muryamuya/auto-spray-esp8266-atmega328p/schematics/1st iteration/mainboard/mainboard.kicad_pcb

## KiCad design schematics/1st iteration/mainboard/mainboard.kicad_pcb (2023-01-12)

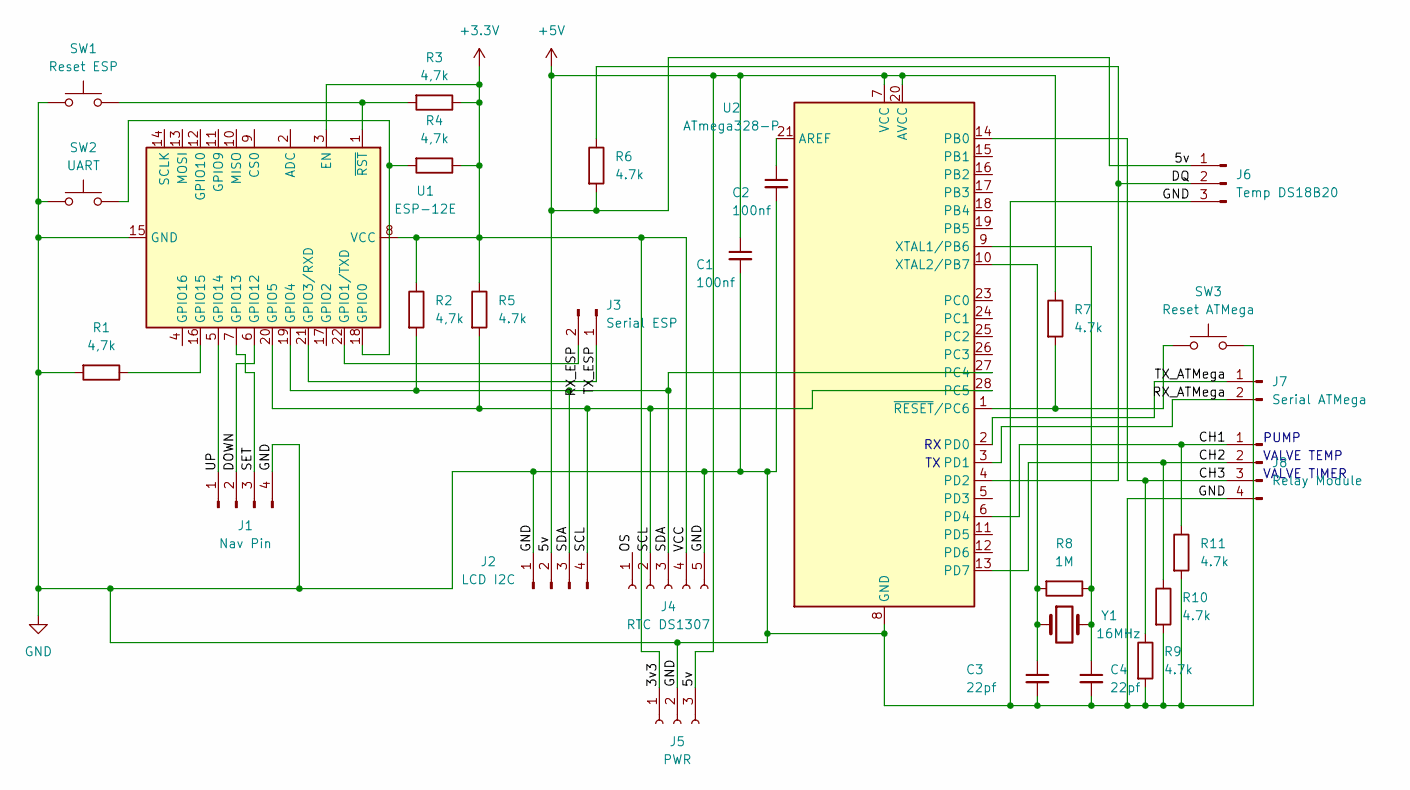
[picture p1: schematic mainboard.kicad_sch]

Parts:
C1, C2: 100nf; C_Disc_D4.7mm_W2.5mm_P5.00mm
C3, C4: 22pf; C_Disc_D4.7mm_W2.5mm_P5.00mm
J1: Nav Pin; PinHeader_1x04_P2.54mm_Vertical
J2: LCD I2C; PinHeader_1x04_P2.54mm_Vertical
J3: Serial ESP; PinHeader_1x02_P2.54mm_Vertical
J4: RTC DS1307; PinSocket_1x05_P2.54mm_Vertical
J5: PWR; TerminalBlock_bornier-3_P5.08mm
J6: Temp DS18B20; PinHeader_1x03_P2.54mm_Vertical
J7: Serial ATMega; PinHeader_1x02_P2.54mm_Vertical
J8: Relay Module; PinHeader_1x04_P2.54mm_Vertical
R1, R2, R3, R4: 4,7k; R_Axial_DIN0207_L6.3mm_D2.5mm_P7.62mm_Horizontal
R5, R6, R7, R9, R10, R11: 4.7k; R_Axial_DIN0207_L6.3mm_D2.5mm_P7.62mm_Horizontal
R8: 1M; R_Axial_DIN0207_L6.3mm_D2.5mm_P7.62mm_Horizontal
SW1: Reset ESP; SW_PUSH_6mm
SW2: UART; SW_PUSH_6mm
SW3: Reset ATMega; SW_PUSH_6mm
U1: ESP-12E
U2: ATmega328-P; DIP-28_W7.62mm
Y1: 16MHz; Crystal_HC49-U_Vertical

Connections:
+3.3V: J4.4, J5.1, R2.1, R3.1, R4.1, R5.1, U1.3 (EN), U1.8 (VCC)
+5V: C1.1, J2.2, J5.3, J6.1, R6.2, R7.1, U2.7 (VCC), U2.20 (AVCC)
/CH1: J8.1, R11.1, U2.6 (PD4)
/CH2: J8.2, R10.1, U2.13 (PD7)
/CH3: J8.3, R9.1, U2.14 (PB0)
/DOWN: J1.2, U1.6 (GPIO12)
/DQ: J6.2, R6.1, U2.4 (PD2)
/OS: J4.1
/RX_ATMega: J7.2, U2.3 (PD1)
/RX_ESP: J3.2, U1.22 (GPIO1/TXD)
/SCL: J2.4, J4.2, R5.2, U1.20 (GPIO5), U2.28 (PC5)
/SDA: J2.3, J4.3, R2.2, U1.19 (GPIO4), U2.27 (PC4)
/SET: J1.3, U1.7 (GPIO13)
/TX_ATMega: J7.1, U2.2 (PD0)
/TX_ESP: J3.1, U1.21 (GPIO3/RXD)
/UP: J1.1, U1.5 (GPIO14)
GND: C1.2, C2.2, C3.2, C4.2, J1.4, J2.1, J4.5, J5.2, J6.3, J8.4, R1.2, R9.2, R10.2, R11.2, SW1.1, SW2.1, SW3.1, U1.15 (GND), U2.8 (GND), U2.22 (GND)
unnamed: C2.1, U2.21 (AREF)
unnamed: C3.1, R8.2, U2.10 (XTAL2/PB7), Y1.1
unnamed: C4.1, R8.1, U2.9 (XTAL1/PB6), Y1.2
unnamed: R1.1, U1.16 (GPIO15)
unnamed: R3.2, SW1.2, U1.1 (~RST)
unnamed: R4.2, SW2.2, U1.18 (GPIO0)
unnamed: R7.2, SW3.2, U2.1 (~RESET/PC6)

Notes on the sheet:
VALVE TIMER
VALVE TEMP
PUMP

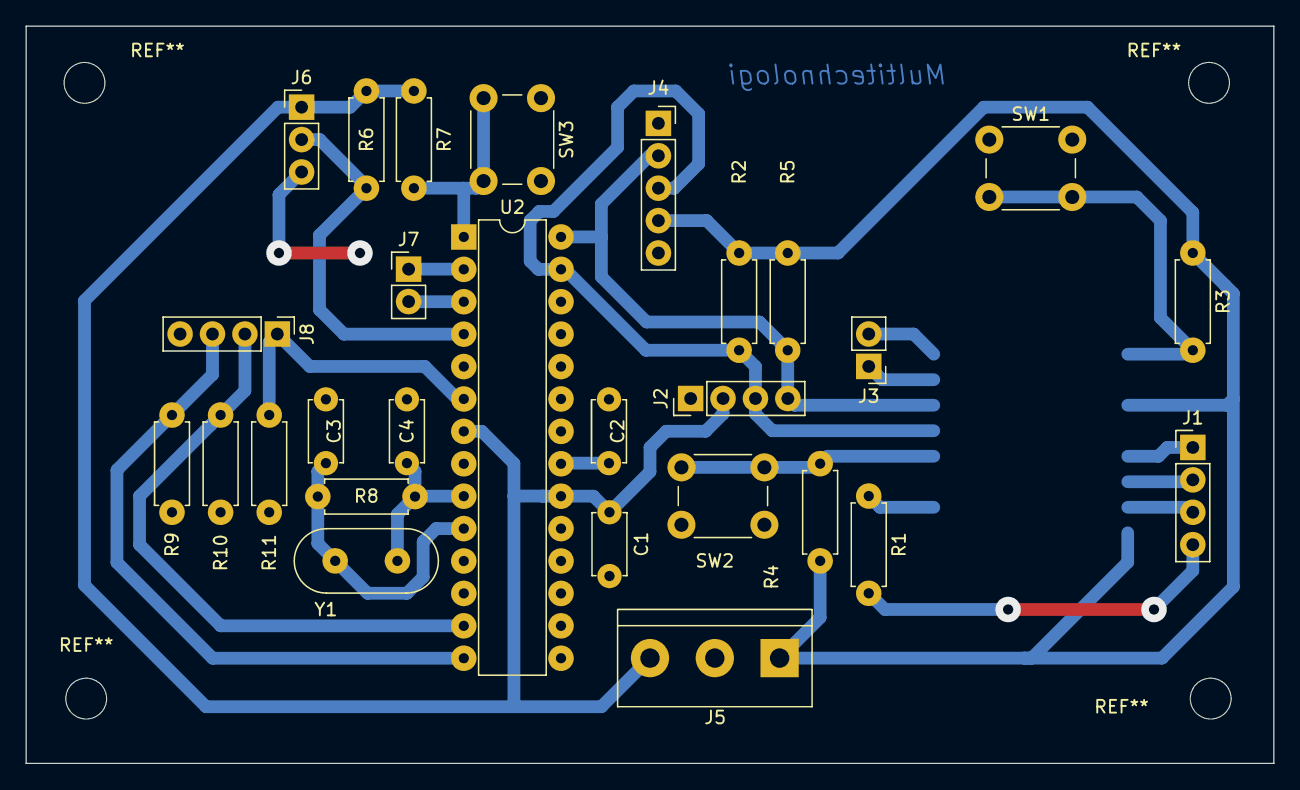
[picture p2: board schematics/1st iteration/mainboard/mainboard.kicad_pcb from above]

Board: 2 copper layers, 97.8 x 57.8 mm, 29 parts (1 on the bottom side), 23 nets.
