muryamuya/auto-spray-esp8266-atmega328p/schematics/2nd iteration/mainboard/mainboard.kicad_pcb

## KiCad design schematics/2nd iteration/mainboard/mainboard.kicad_pcb (2023-01-12)

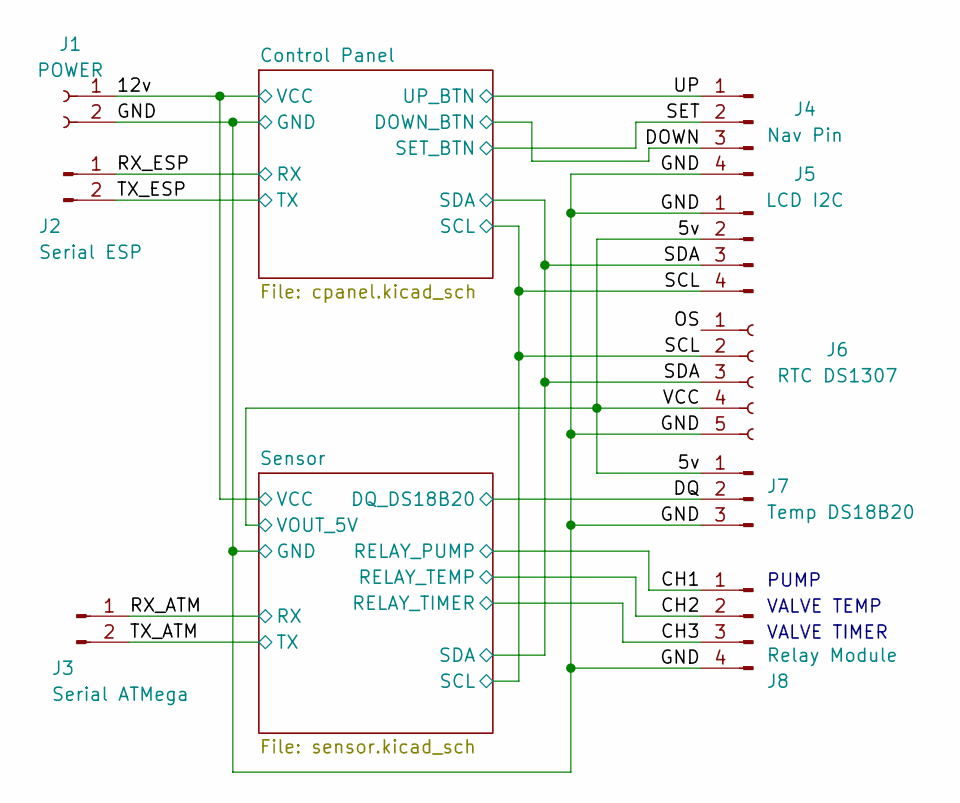
[picture p3: schematic mainboard.kicad_sch]

Parts:
J1: POWER; TerminalBlock_bornier-2_P5.08mm
J2: Serial ESP; PinHeader_1x02_P2.54mm_Vertical
J3: Serial ATMega; PinHeader_1x02_P2.54mm_Vertical
J4: Nav Pin; PinHeader_1x04_P2.54mm_Vertical
J5: LCD I2C; PinHeader_1x04_P2.54mm_Vertical
J6: RTC DS1307; PinSocket_1x05_P2.54mm_Vertical
J7: Temp DS18B20; PinHeader_1x03_P2.54mm_Vertical
J8: Relay Module; PinHeader_1x04_P2.54mm_Vertical

Connections:
/5v: J5.2, J6.4, J7.1; also elsewhere on the board
/12v: J1.1; also elsewhere on the board
/CH1: J8.1; also elsewhere on the board
/CH2: J8.2; also elsewhere on the board
/CH3: J8.3; also elsewhere on the board
/DOWN: J4.3; also elsewhere on the board
/DQ: J7.2; also elsewhere on the board
/GND: J1.2, J4.4, J5.1, J6.5, J7.3, J8.4; also elsewhere on the board
/OS: J6.1
/RX_ATM: J3.1; also elsewhere on the board
/RX_ESP: J2.1; also elsewhere on the board
/SCL: J5.4, J6.2; also elsewhere on the board
/SDA: J5.3, J6.3; also elsewhere on the board
/SET: J4.2; also elsewhere on the board
/TX_ATM: J3.2; also elsewhere on the board
/TX_ESP: J2.2; also elsewhere on the board
/UP: J4.1; also elsewhere on the board

Notes on the sheet:
VALVE TIMER
VALVE TEMP
PUMP

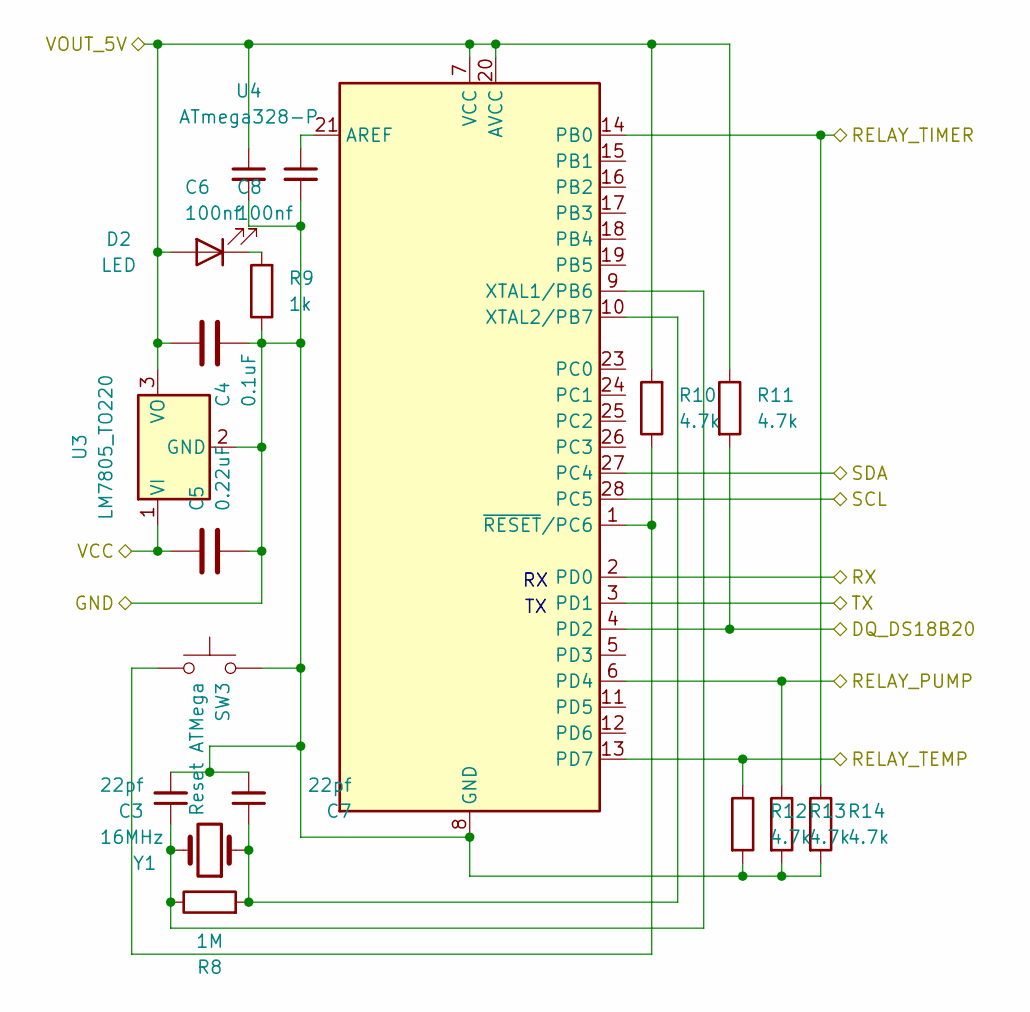
[picture p4: schematic sensor.kicad_sch]

Parts:
C3, C7: 22pf; C_Disc_D4.7mm_W2.5mm_P5.00mm
C4: 0.1uF; C_Disc_D4.7mm_W2.5mm_P5.00mm
C5: 0.22uF; C_Disc_D4.7mm_W2.5mm_P5.00mm
C6, C8: 100nf; C_Disc_D4.7mm_W2.5mm_P5.00mm
D2: LED; LED_D5.0mm
R8: 1M; R_Axial_DIN0207_L6.3mm_D2.5mm_P7.62mm_Horizontal
R9: 1k; R_Axial_DIN0207_L6.3mm_D2.5mm_P7.62mm_Horizontal
R10, R11, R12, R13, R14: 4.7k; R_Axial_DIN0207_L6.3mm_D2.5mm_P7.62mm_Horizontal
SW3: Reset ATMega; SW_PUSH_6mm
U3: LM7805_TO220; TO-220-3_Horizontal_TabDown
U4: ATmega328-P; DIP-28_W7.62mm
Y1: 16MHz; Crystal_HC49-U_Vertical

Connections:
/5v: C4.1, C6.1, D2.2 (A), R10.2, R11.1, U3.3 (VO), U4.7 (VCC), U4.20 (AVCC); also elsewhere on the board
/12v: C5.1, U3.1 (VI); also elsewhere on the board
/CH1: R13.1, U4.6 (PD4); also elsewhere on the board
/CH2: R12.1, U4.13 (PD7); also elsewhere on the board
/CH3: R14.1, U4.14 (PB0); also elsewhere on the board
/DQ: R11.2, U4.4 (PD2); also elsewhere on the board
/GND: C3.2, C4.2, C5.2, C6.2, C7.2, C8.2, R9.1, R12.2, R13.2, R14.2, SW3.1, U3.2 (GND), U4.8 (GND), U4.22 (GND); also elsewhere on the board
/RX_ATM: U4.2 (PD0); also elsewhere on the board
/SCL: U4.28 (PC5); also elsewhere on the board
/SDA: U4.27 (PC4); also elsewhere on the board
/TX_ATM: U4.3 (PD1); also elsewhere on the board
unnamed: C3.1, R8.1, U4.9 (XTAL1/PB6), Y1.2
unnamed: C7.1, R8.2, U4.10 (XTAL2/PB7), Y1.1
unnamed: C8.1, U4.21 (AREF)
unnamed: D2.1 (K), R9.2
unnamed: R10.1, SW3.2, U4.1 (~RESET/PC6)

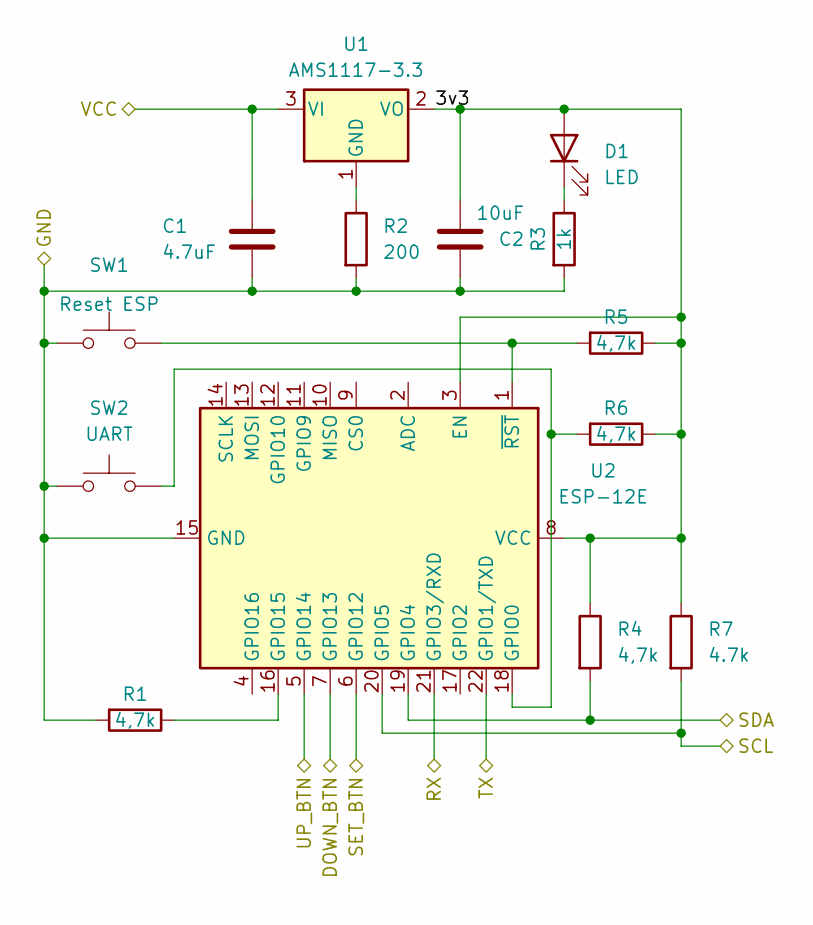
[picture p5: schematic cpanel.kicad_sch]

Parts:
C1: 4.7uF; C_Disc_D4.7mm_W2.5mm_P5.00mm
C2: 10uF; C_Disc_D4.7mm_W2.5mm_P5.00mm
D1: LED; LED_D5.0mm
R1, R4, R5, R6: 4,7k; R_Axial_DIN0207_L6.3mm_D2.5mm_P7.62mm_Horizontal
R2: 200; R_Axial_DIN0207_L6.3mm_D2.5mm_P7.62mm_Horizontal
R3: 1k; R_Axial_DIN0207_L6.3mm_D2.5mm_P7.62mm_Horizontal
R7: 4.7k; R_Axial_DIN0207_L6.3mm_D2.5mm_P7.62mm_Horizontal
SW1: Reset ESP; SW_PUSH_6mm
SW2: UART; SW_PUSH_6mm
U1: AMS1117-3.3; SOT-223-3_TabPin2
U2: ESP-12E

Connections:
/12v: C1.2, U1.3 (VI); also elsewhere on the board
/Control Panel/3v3: C2.2, D1.2 (A), R4.1, R5.1, R6.1, R7.1, U1.2 (VO), U2.3 (EN), U2.8 (VCC)
/DOWN: U2.7 (GPIO13); also elsewhere on the board
/GND: C1.1, C2.1, R1.2, R2.2, R3.2, SW1.1, SW2.1, U2.15 (GND); also elsewhere on the board
/RX_ESP: U2.21 (GPIO3/RXD); also elsewhere on the board
/SCL: R7.2, U2.20 (GPIO5); also elsewhere on the board
/SDA: R4.2, U2.19 (GPIO4); also elsewhere on the board
/SET: U2.6 (GPIO12); also elsewhere on the board
/TX_ESP: U2.22 (GPIO1/TXD); also elsewhere on the board
/UP: U2.5 (GPIO14); also elsewhere on the board
unnamed: D1.1 (K), R3.1
unnamed: R1.1, U2.16 (GPIO15)
unnamed: R2.1, U1.1 (GND)
unnamed: R5.2, SW1.2, U2.1 (~RST)
unnamed: R6.2, SW2.2, U2.18 (GPIO0)

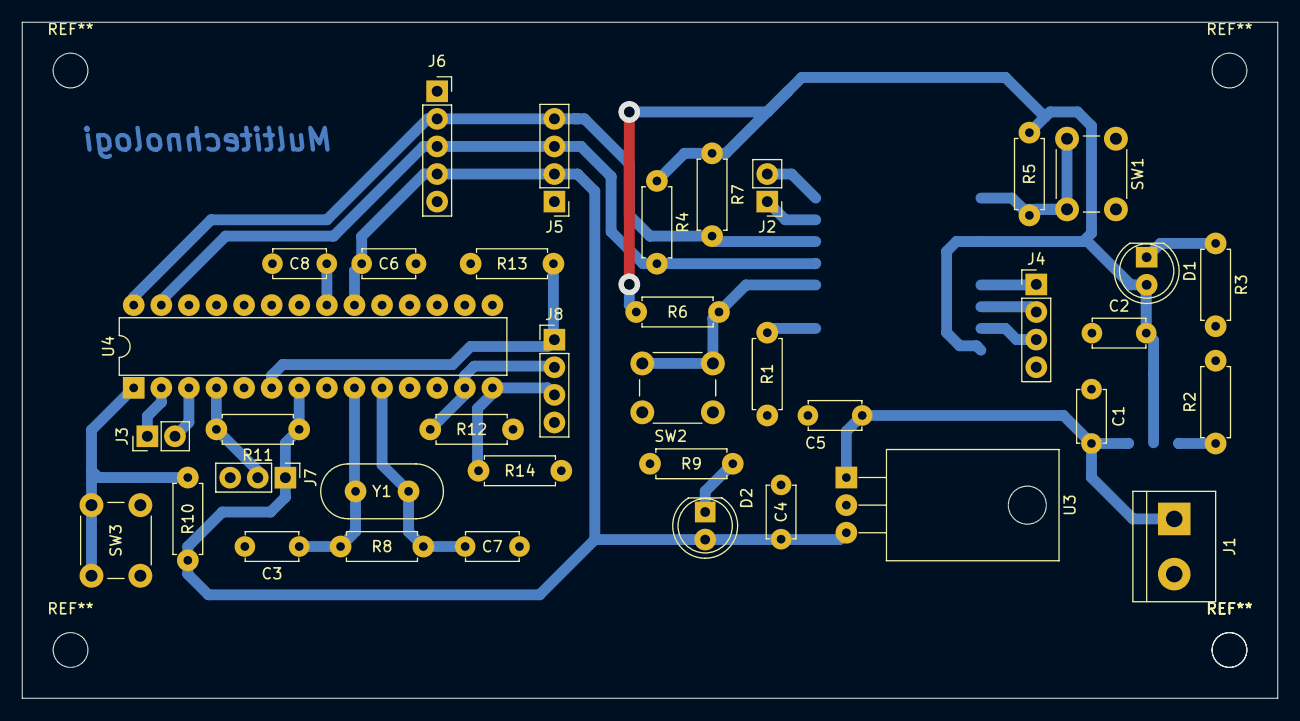
[picture p6: board schematics/2nd iteration/mainboard/mainboard.kicad_pcb from above]

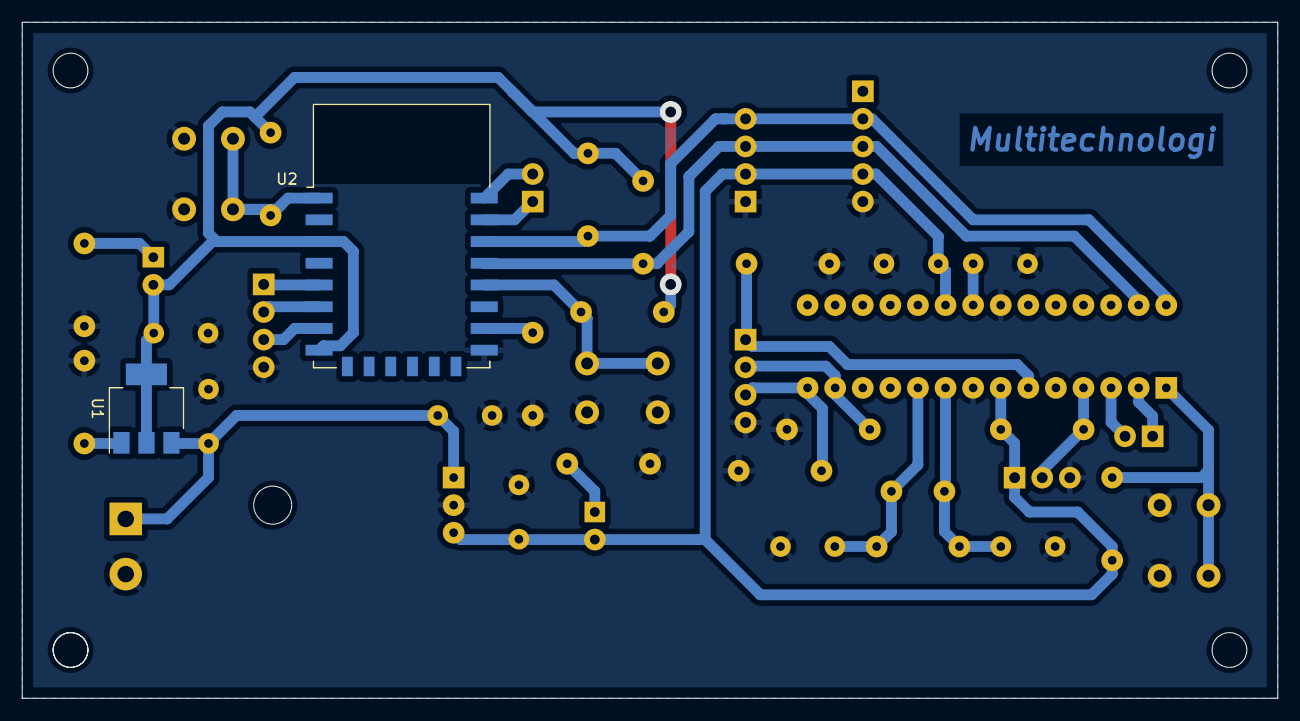
[picture p7: board schematics/2nd iteration/mainboard/mainboard.kicad_pcb from below]

Board: 2 copper layers, 115.6 x 62.2 mm, 40 parts (2 on the bottom side), 27 nets.
