muryamuya/auto-spray-esp8266-atmega328p/schematics/2nd iteration/auxiliary/auxiliary.kicad_pcb

## KiCad design schematics/2nd iteration/auxiliary/auxiliary.kicad_pcb (2023-01-12)

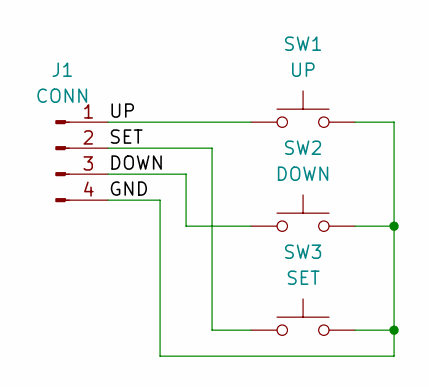
[picture p8: schematic auxiliary.kicad_sch]

Parts:
J1: CONN; PinHeader_1x04_P2.54mm_Horizontal
SW1: UP; SW_PUSH_6mm
SW2: DOWN; SW_PUSH_6mm
SW3: SET; SW_PUSH_6mm

Connections:
/DOWN: J1.3, SW2.1
/GND: J1.4, SW1.2, SW2.2, SW3.2
/SET: J1.2, SW3.1
/UP: J1.1, SW1.1

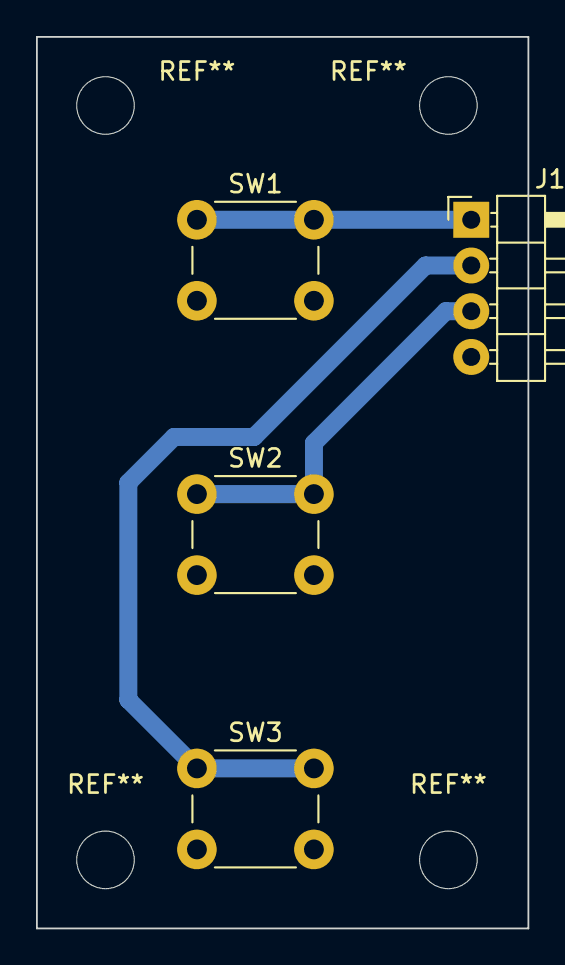
[picture p9: board auxiliary.kicad_pcb from above]

Board: 2 copper layers, 27.3 x 49.5 mm, 4 parts (0 on the bottom side), 4 nets.
