muryamuya/auto-spray-esp8266-atmega328p/(commit log)

2022-10-18 Initial add
    Adding project files to repo
    [schematic.kicad_pcb, schematic.kicad_sch]
2022-10-19 rework folder structure, need convert ino to cpp
    [schematic.kicad_pcb, schematic.kicad_sch]
2022-10-24 fixed var overflow, backlight, rollover millis
2022-11-02 added schematic, updated index.html and filesys
    [auto-spray-esp8266-atmega328p.kicad_pcb, auto-spray-esp8266-atmega328p.kicad_sch]
2022-11-14 fix schematics, added button schematics
    [auto-spray-esp8266-atmega328p.kicad_pcb, auxiliary.kicad_pcb, auxiliary.kicad_sch, mainboard.kicad_pcb, mainboard.kicad_sch]
2022-11-18 cleanup, added net labels
    [auxiliary.kicad_sch, mainboard.kicad_sch]
2022-12-01 minor fix schematics
    [auxiliary.kicad_pcb, mainboard.kicad_pcb, mainboard.kicad_sch]
2023-01-12 added debugging uart and rework board
    [auxiliary.kicad_pcb, auxiliary.kicad_sch, cpanel.kicad_sch, mainboard.kicad_pcb, mainboard.kicad_sch, sensor.kicad_sch]
2023-02-01 main fixed debugging delay, aux add fault prevent
    [auto_spray_aux.cpp, auto_spray_main_wifi.cpp]
